ALAN3D/ME498-Research/Pictures/175ABS_Water.jpg

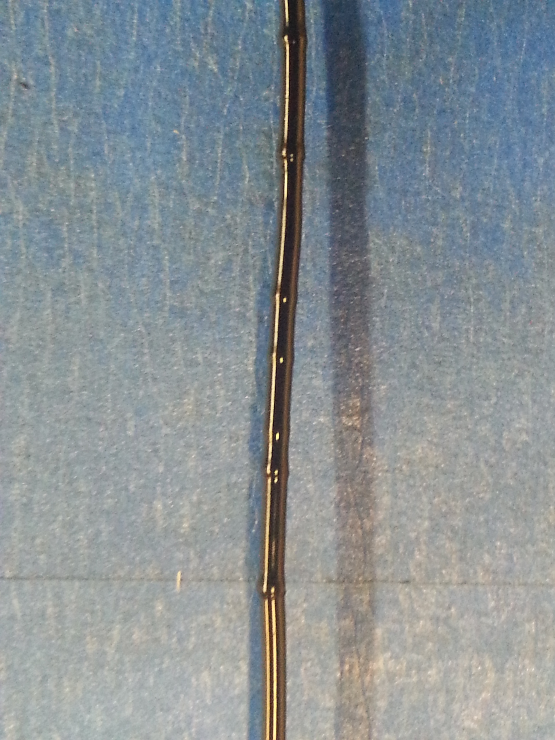
Pictures/175ABS_Water.jpg
