ALAN3D/ME498-Research/Pictures/0303151739.jpg

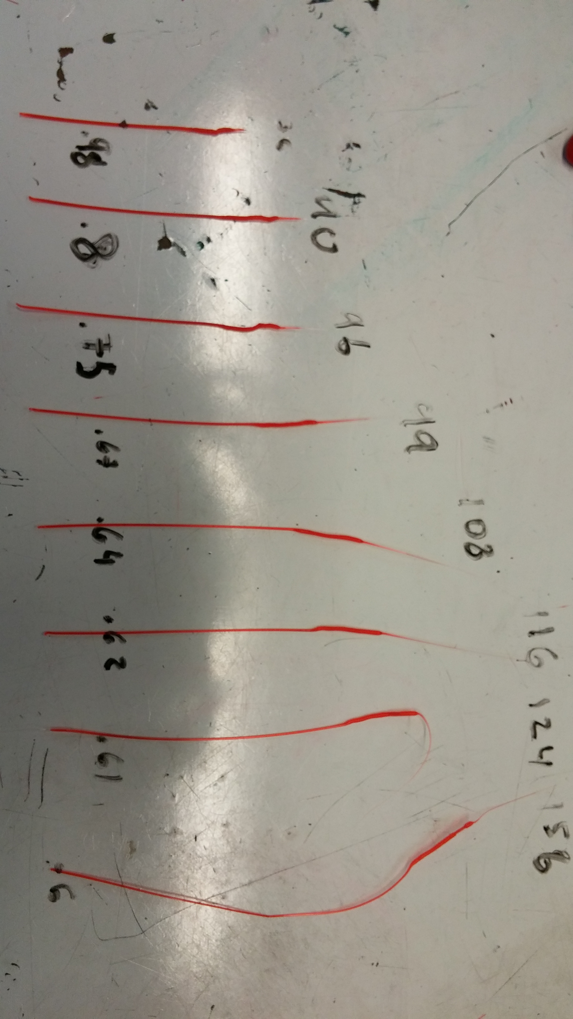
Pictures/0303151739.jpg
