ALAN3D/ME498-Research/Table2/Table 7.docx

Table 7 - Pulled Filament Length at Varying Temp’s

Data

MELT | DRIVE | DIAMETER | ORIFICE | MATERIAL | Flow Rate | LENGTH
Volcano | Direct | 1.75 mm | 1.2 mm | ABS | 2200mm^3/s | 50 mm

Temp Celsius | Length of Pulled Filament(mm)
240 | 9.28mm
250 | 16.34mm
260 | 18.48mm
270 | 20.50mm

Rate of pulled filament/increase in temperature is .374mm/C

Summary:

- After noticing that at the failure rates, less than the specified filament was pulled, we decided to measure the pulled filament at the failure flow rate as the temperature was increased.

Notes/Observations:

- We noticed that as the temperature increased the motor grinding noise became noticeably less audible.
- The explanation for the lack of filament being pulled in general has a two-fold explanation. First, the motor is reaching its maximum speed so the torque is decreasing thus it can no longer exert the force to drive the filament. The second explanation is that the since the filament is moving so fast it doesn’t spend enough time in the hot end to heat up to its melting point. This data shows that the pulled filament length increased by about 10mm from 240 all the way to 270. Thus it is shown that the of extruder temperature does contribute to an lower failure volumetric flow rate hence increasing the temperature allows for the filament passing through the hot end at high speeds reach a temperature closer to its actual melting point.
- An important observation is that the pulled filament by increase in temperature rate for ABS is 3 times the size of that for PLA. The reason for this is contained in theory 2.25. The higher thermal conductivity for ABS and the lower specific heat capacity results in a greater change in temperature thus ABS melts more the higher the temperature increases compared to PLA thus the rate of filament pulled for ABS is 3 times higher for every degree increase in temperature.

Specifications:

- Yellow Octave ABS 1.75mm
- 1.2mm orifice, E3D volcano
- Spring Tension: (~58.70 mm for 3mm) (~58.90 mm for 1.75mm)

Failure Mode: Not applicable for this trial.
