ALAN3D/ME498-Research/Table2/Tables README.rtf

Organization of which table corresponds to which information

Table:

1 1.75mm BlackABS 1.2mmOrif 2/28/15 Testing Regular Failure
2 1.75mm YellowABS 1.2mmOrif 2/28/15 Testing Regular Failure
3 1.75mm RedPLA 0.6mmOrif 3/1/15 Testing Regular Failure
4 1.75mm RedPLA 1.2mmOrif 2/28/15 Testing Regular Failure
5 3.00mm YellowABS 1.2mmOrif 2/26/15 Testing Regular Failure
6 3.00mm REdPLA 1.2mmOrif 2/26/15 Testing Regular Failure
7 1.75mm YellowABS 1.2mmOr 3/4/15 Testing if High temp reduces failure
8 1.75mm RedPLA 1.2mmOr 3/4/15 Testing if High temp reduces failure
9 1.75mm RedPLA 0.6mmOr 3/3/15 Testing if High temp reduces failure testing extruded filament
10 1.75mm YelowABS 0.6mmOr 3/3/15 Testing if High temp reduces failure testing extruded filament
11
