ALAN3D/ME498-Research/Pictures/0303151738.jpg

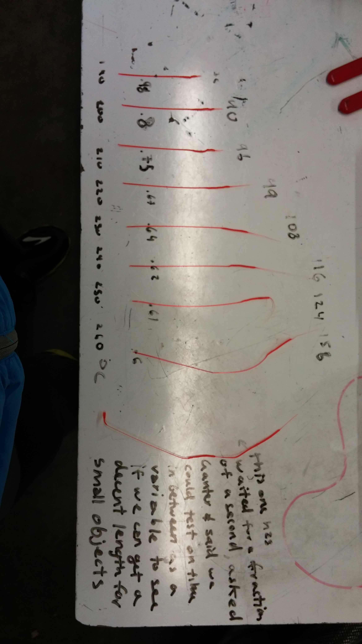
Pictures/0303151738.jpg
