ALAN3D/ME498-Research/Pictures/0303151758.jpg

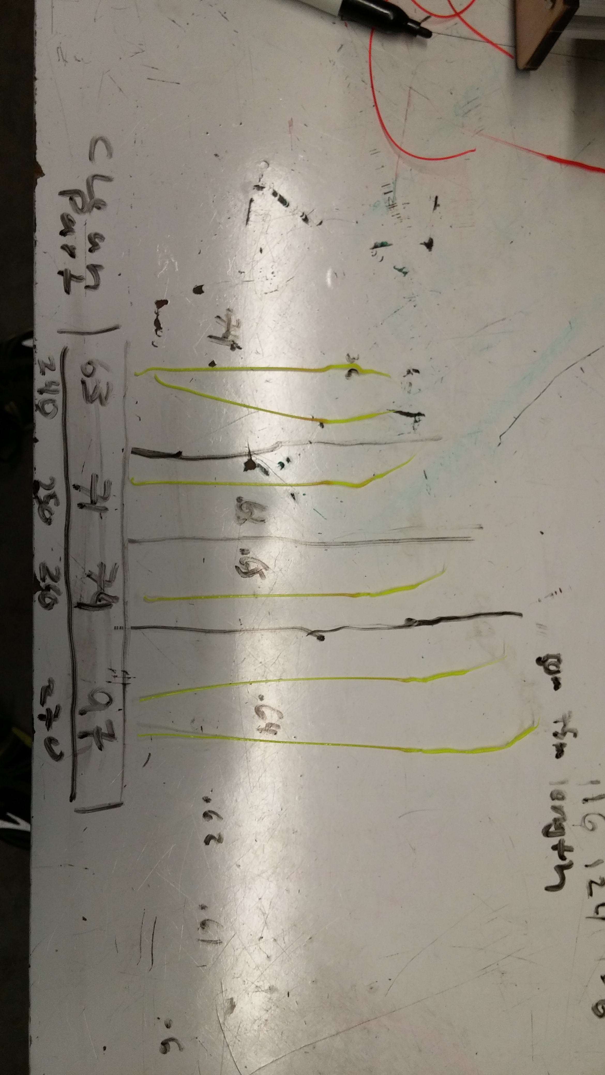
Pictures/0303151758.jpg
