ALAN3D/ME498-Research/Print Files/jonaskuehling_gregs-wade-v3_idler-only.stl

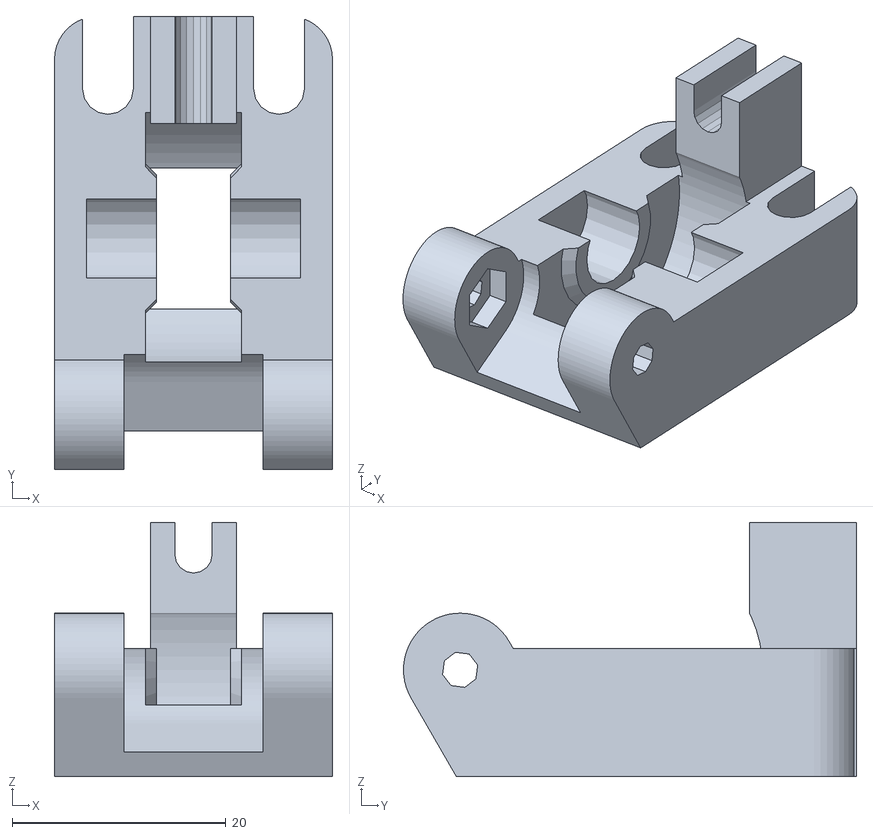
[picture p8: CAD file, 2015-03-02]
Print Files/jonaskuehling_gregs-wade-v3_idler-only.stl
26.0 x 42.4 x 23.8
