ALAN3D/ME498-Research/Print Files/MotorSpacer2mm.SLDPRT

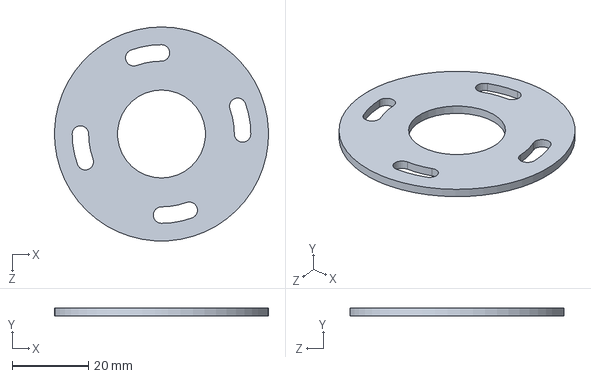
[picture p9: CAD file, 2015-03-02]
Print Files/MotorSpacer2mm.SLDPRT
56.0 x 2.00 x 56.0 mm
