ALAN3D/ME498-Research/Print Files/biggearmod_fixed.stl

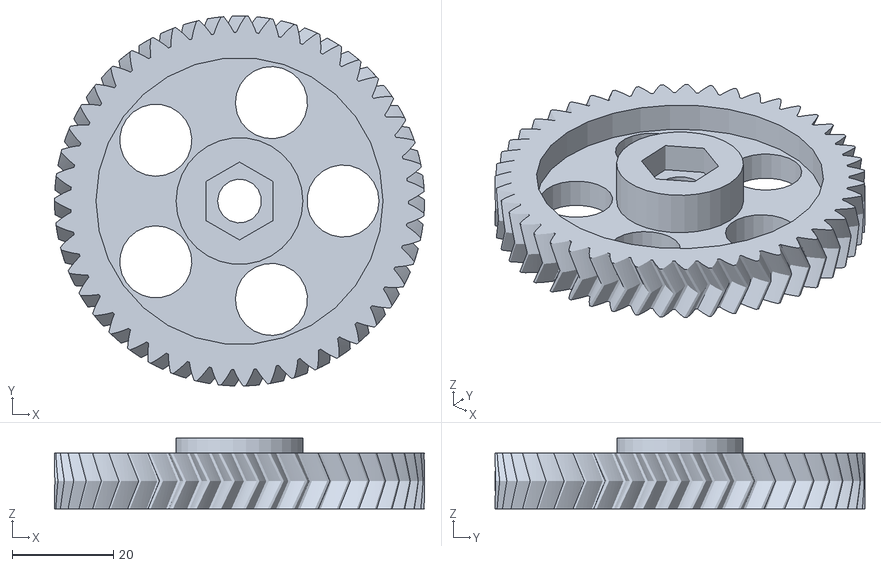
[picture p10: CAD file, 2015-03-02]
Print Files/biggearmod_fixed.stl
73.0 x 73.0 x 14.0
