ALAN3D/ME498-Research/Print Files/extruder_latch-2.0.stl

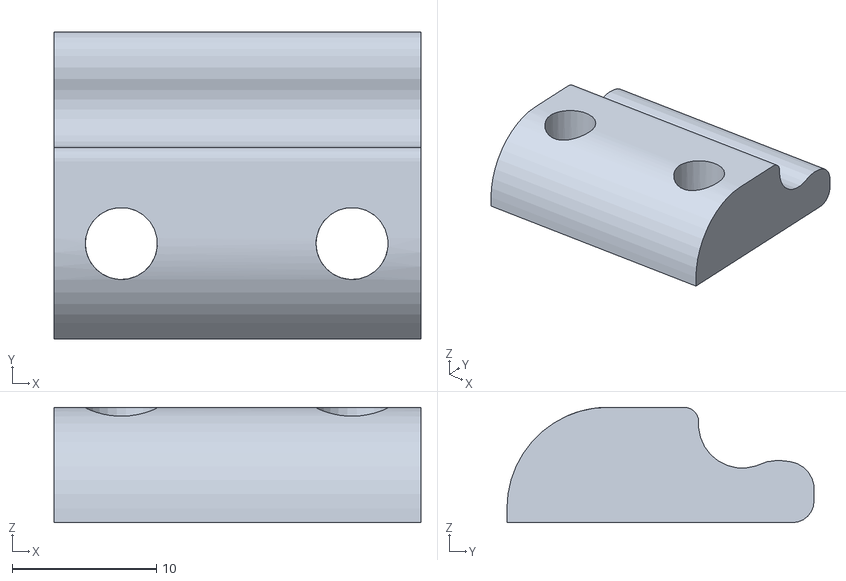
[picture p11: CAD file, 2015-03-02]
Print Files/extruder_latch-2.0.stl
25.5 x 21.3 x 8.00
