ALAN3D/ME498-Research/Print Files/Quick_change_filament_for_Jonaskuehling_Extruder.stl

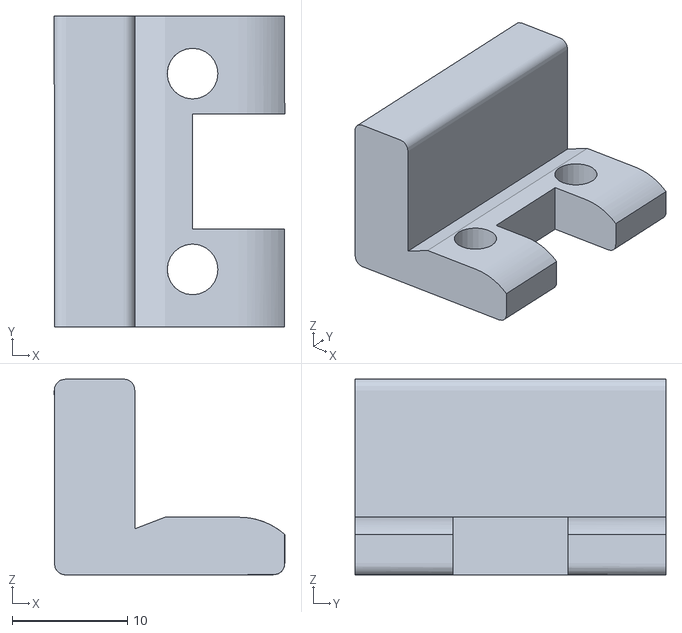
[picture p12: CAD file, 2015-03-02]
Print Files/Quick_change_filament_for_Jonaskuehling_Extruder.stl
20.0 x 27.0 x 17.0
