ALAN3D/ME498-Research/Print Files/AL175 - jonaskuehling Gregs Wade E3D v6 1.75mm Universal.stl

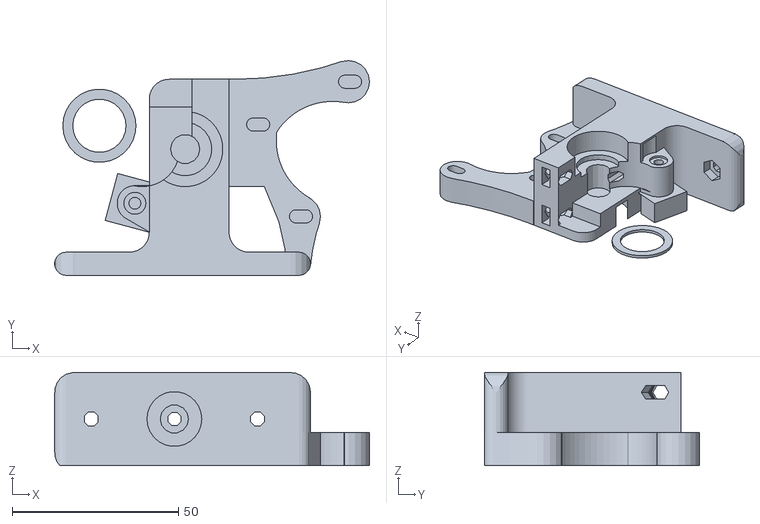
[picture p13: CAD file, 2015-03-02]
Print Files/AL175 - jonaskuehling Gregs Wade E3D v6 1.75mm Universal.stl
94.7 x 64.6 x 28.0
