ALAN3D/ME498-Research/Print Files/smallgearmod_fixed.stl

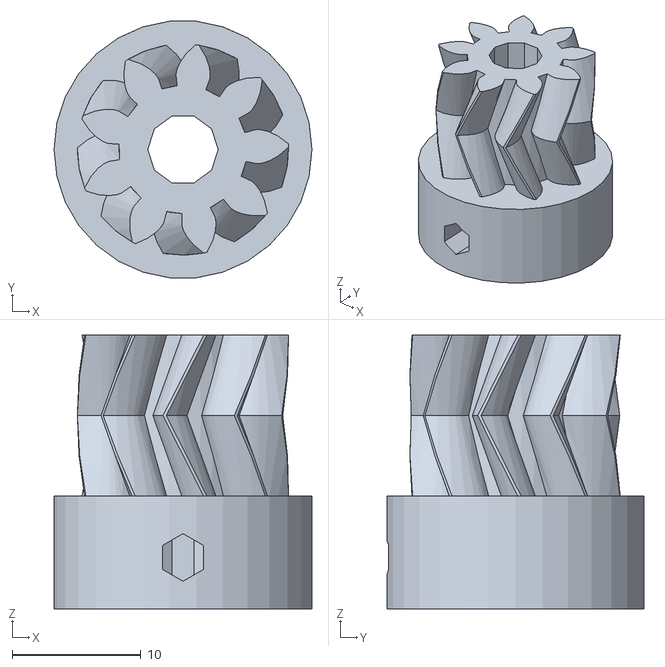
[picture p14: CAD file, 2015-03-02]
Print Files/smallgearmod_fixed.stl
20.0 x 19.9 x 21.2
