ALAN3D/ME498-Research/Print Files/jonaskuehling_gregs-wade-v3_groovemount.stl

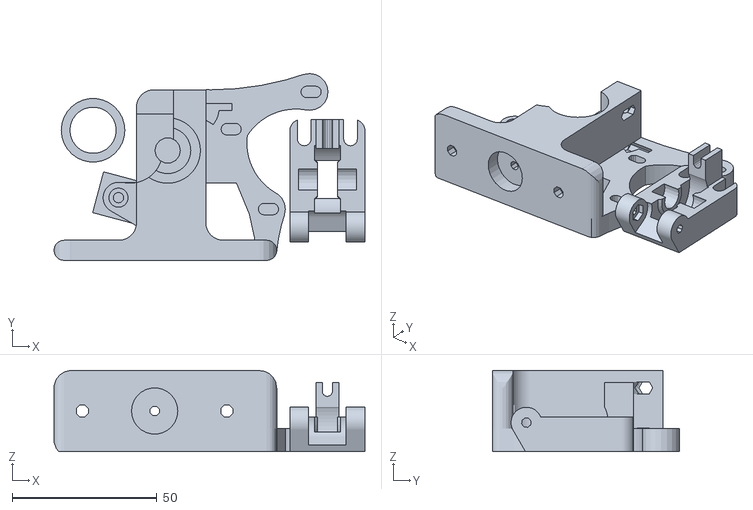
[picture p15: CAD file, 2015-03-02]
Print Files/jonaskuehling_gregs-wade-v3_groovemount.stl
107.5 x 64.6 x 28.0
