ALAN3D/ME498-Research/Print Files/V2_3mmdecjkwadejmnt_fixed.stl

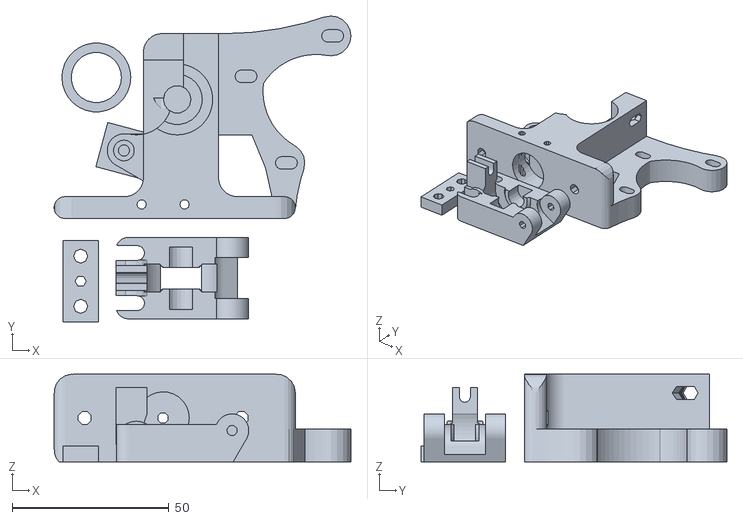
[picture p16: CAD file, 2015-03-02]
Print Files/V2_3mmdecjkwadejmnt_fixed.stl
94.7 x 97.6 x 28.0
