ALAN3D/ME498-Research/Print Files/Gregs_Wade_reloaded_-_Guidler_Tilt_Screws_Fishbone_Gears/Gregs_Wade_reloaded_-_Guidler_Tilt_Screws_Fishbone_Gears/jonaskuehling_gregs-wade-v3_reprapfaborg.stl

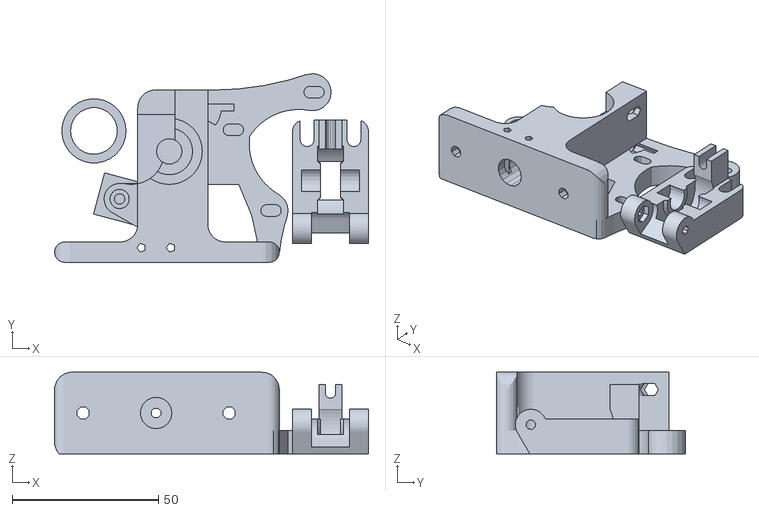
[picture p17: CAD file, 2015-03-02]
Print Files/Gregs_Wade_reloaded_-_Guidler_Tilt_Screws_Fishbone_Gears/Gregs_Wade_reloaded_-_Guidler_Tilt_Screws_Fishbone_Gears/jonaskuehling_gregs-wade-v3_reprapfaborg.stl
107.5 x 64.6 x 28.0
