ALAN3D/ME498-Research/Print Files/Gregs_Wade_reloaded_-_Guidler_Tilt_Screws_Fishbone_Gears/Gregs_Wade_reloaded_-_Guidler_Tilt_Screws_Fishbone_Gears/small-gear-mod_holedia-4-2.stl

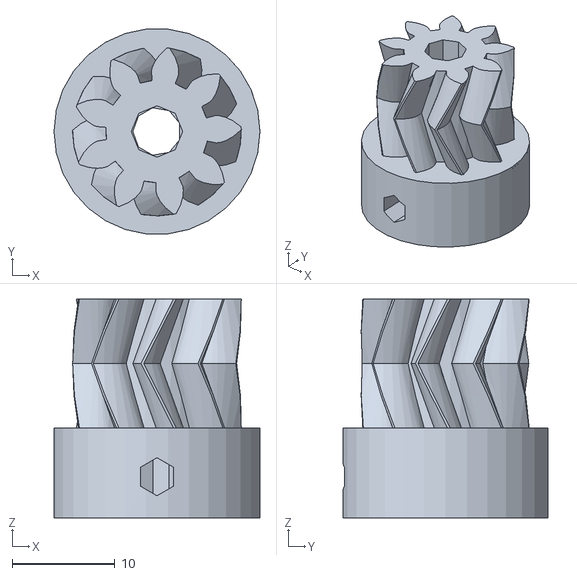
[picture p18: CAD file, 2015-03-02]
Print Files/Gregs_Wade_reloaded_-_Guidler_Tilt_Screws_Fishbone_Gears/Gregs_Wade_reloaded_-_Guidler_Tilt_Screws_Fishbone_Gears/small-gear-mod_holedia-4-2.stl
20.0 x 19.9 x 21.2
