ALAN3D/ME498-Research/(list of files, cad)

Other CAD files:
Print Files/jonaskuehling Gregs Wade E3D v6 3mm Bowden.stl
Print Files/Gregs_Wade_reloaded_-_Guidler_Tilt_Screws_Fishbone_Gears/Gregs_Wade_reloaded_-_Guidler_Tilt_Screws_Fishbone_Gears/big-gear-mod_SAE.stl
Print Files/Gregs_Wade_reloaded_-_Guidler_Tilt_Screws_Fishbone_Gears/Gregs_Wade_reloaded_-_Guidler_Tilt_Screws_Fishbone_Gears/jonaskuehling_gregs-wade-v3_jhead-LAYER-0-35.stl
Print Files/Gregs_Wade_reloaded_-_Guidler_Tilt_Screws_Fishbone_Gears/Gregs_Wade_reloaded_-_Guidler_Tilt_Screws_Fishbone_Gears/jonaskuehling_gregs-wade-v3_jhead.stl
Print Files/Gregs_Wade_reloaded_-_Guidler_Tilt_Screws_Fishbone_Gears/Gregs_Wade_reloaded_-_Guidler_Tilt_Screws_Fishbone_Gears/jonaskuehling_gregs-wade-v3.scad
Print Files/Gregs_Wade_reloaded_-_Guidler_Tilt_Screws_Fishbone_Gears/Gregs_Wade_reloaded_-_Guidler_Tilt_Screws_Fishbone_Gears/jonaskuehling_gregs-wade-v3_MOD_175.scad
Print Files/Gregs_Wade_reloaded_-_Guidler_Tilt_Screws_Fishbone_Gears/Gregs_Wade_reloaded_-_Guidler_Tilt_Screws_Fishbone_Gears/jonaskuehling_gregs-wade-v3_MOD_300.scad
Print Files/Gregs_Wade_reloaded_-_Guidler_Tilt_Screws_Fishbone_Gears/Gregs_Wade_reloaded_-_Guidler_Tilt_Screws_Fishbone_Gears/configuration.scad
Print Files/Gregs_Wade_reloaded_-_Guidler_Tilt_Screws_Fishbone_Gears/Gregs_Wade_reloaded_-_Guidler_Tilt_Screws_Fishbone_Gears/functions.scad
Print Files/Gregs_Wade_reloaded_-_Guidler_Tilt_Screws_Fishbone_Gears/Gregs_Wade_reloaded_-_Guidler_Tilt_Screws_Fishbone_Gears/gregs-wadebits.scad
Print Files/Gregs_Wade_reloaded_-_Guidler_Tilt_Screws_Fishbone_Gears/Gregs_Wade_reloaded_-_Guidler_Tilt_Screws_Fishbone_Gears/jonaskuehling-default.scad
Print Files/Gregs_Wade_reloaded_-_Guidler_Tilt_Screws_Fishbone_Gears/Gregs_Wade_reloaded_-_Guidler_Tilt_Screws_Fishbone_Gears/jonaskuehling_gregs-wade-v3_SAE_groovemount.stl
Print Files/Gregs_Wade_reloaded_-_Guidler_Tilt_Screws_Fishbone_Gears/Gregs_Wade_reloaded_-_Guidler_Tilt_Screws_Fishbone_Gears/jonaskuehling_gregs-wade-v3_jhead-BODY-ONLY.stl
Print Files/Gregs_Wade_reloaded_-_Guidler_Tilt_Screws_Fishbone_Gears/Gregs_Wade_reloaded_-_Guidler_Tilt_Screws_Fishbone_Gears/metric.scad
Print Files/MotorSpacer2mm.STL
Print Files/configuration.scad
Print Files/functions.scad
Print Files/gregs-wadebits.scad
Print Files/jonaskuehling-default.scad
Print Files/jonaskuehling_gregs-wade-v3 (1).scad
Print Files/metric.scad
