ALAN3D/ME498-Research/No Longer Useful/TESTS2.docx

Test Variable: Filament Material (ABS)

MELT | DRIVE | DIAMETER | ORIFICE | MATERIAL | TEMP | LENGTH
Volcano | Direct | 3.00 mm | 1.2 mm | ABS | 240 C | 50 mm

Speed (mm/min) | Trial 1 | Trial 2 | Trial 3 | Trial 4 | Trial 5 | Trial 6 | Trial 7 | Trial 8 | Deviation Measurement
50
75
100
125
150
175 | | | | | | | | | 65.187
200 | | | | | | | | | 21.517
225 | | | | | | | | | 18.277
250
275
300
325
350
375
400

Maximum Se

Observations:

- Deviations in form of blob
- 175: First sign of blobs, 1 blob in all 8 trials
- 200: Around 3 blobs
- 225: Blobs affect power accumulation

Test Variable: Filament Material (PLA)

MELT | DRIVE | DIAMETER | ORIFICE | MATERIAL | TEMP | LENGTH
Volcano | Direct | 3.00 mm | 1.2 mm | ABS | 240 C | 50 mm

Speed (mm/min) | Trial 1 | Trial 2 | Trial 3 | Trial 4 | Trial 5 | Trial 6 | Trial 7 | Trial 8 | Deviation Measurement
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
Observations:

- Deviations in form of

Test Variable: Nozzle Orifice

MELT | DRIVE | DIAMETER | ORIFICE | MATERIAL | TEMP | LENGTH
Volcano | Direct | 3.00 mm | 1.0 mm | ABS | 240 C | 50 mm

Speed (mm/min) | Trial 1 | Trial 2 | Trial 3 | Trial 4 | Trial 5 | Trial 6 | Trial 7 | Trial 8 | Deviation Measurement
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
Observations:

- Deviations in form of
