ALAN3D/ME498-Research/(commit log)

2015-03-02 Added Stuff
    [AL175 - jonaskuehling Gregs Wade E3D v6 1.75mm Universal.stl, MotorSpacer2mm.SLDPRT, MotorSpacer2mm.STL, Quick_change_filament_for_Jonaskuehling_Extruder.stl, V2_3mmdecjkwadejmnt_fixed.stl, big-gear-mod_SAE.stl, biggearmod_fixed.stl, configuration.scad]
2015-03-03 Increasing Temp Tests
    Seeing how the increased temp can compensate for the failure mode of
    the motor, to result in a higher volumetric flow rate
    [TemperatureVsRates.xlsx]
2015-03-03 Future test ideas
    [TemperatureVsRates.xlsx]
2015-03-04 Trial and Report Updates
    Included some information about data trials as well as pictures, some
    is also written down and will be added to the report today.
    [TemperatureVsRates.xlsx]
2015-03-05 All Tables Categorized
    To look for a certain table go into the Table2 directory and read the
    Table README to figure out which table corresponds to which trial.
    [TemperatureVsRates.xlsx]
2015-03-06 2 Tables Added, Report Updates
    2 Tables added for the temperature trials testing the extruded filament
    quality as well as pictures and 2 paragraphs added to the conclusion of
    the Report.
    [Volumetric Flow Rates.xlsx]
2015-03-08 Volumetric Flow Rate Description Info Added
    equation and quick summary
2015-03-09 Important Obervations/Formatting
    Table 2 and Table 7 have more important observations added to them. The
    data displayed in table 7 and 8 is different now instead of difference
    in length from original 100mm the actual pulled length is added and the
    tables are updated. An additional pulled length increase to temperature
    increase rate is added.
    [TemperatureVsRates.xlsx]
2015-03-09 Table 10 added and TextFile updated
    Don’t know why this one got removed
2015-03-11 Added 3.10.15 ALAN
    My current version of report
2015-03-16 Explanation Revisions
    revisions for specific heat and die swell explanations as well as
    grammatical error revisions
